Shreeyaj005/Darkviz/README.md

# Darkviz 

**Autonomous Omni-Directional Robotic System for Dark-Store Inventory Handling and Order Fulfillment**

---

## Team Details

| Sr. No. | Name of Student | Roll No. | Branch | Email ID |
|---|---|---|---|---|
| 1 | Shreeeya Jadhav | 45  | Automation and Robotics | 2023.shreeya.jadhav@ves.ac.in |
| 2 | Ayush Likhar | 11 | Automation and Robotics | 2023.ayush.likhar@ves.ac.in |
| 3 | Yash Gupta | 44 | Automation and Robotics | 2023.yash.gupta@ves.ac.in |
| 4 | Vedant Chavan | 40 | Automation and Robotics | 2023.vedant.chavan@ves.ac.in |

---
## Proposal 
https://youtu.be/7PNNnmAVzm0?si=SbWJWXD1Y0URtpTx

## Guide Details

**Project Guide: Amudha Senthilkumar**  
**Department:** Automation and Robotics  
**Institute:** VESIT, Mumbai  

---

## Problem Statement

> The aim of this project is to develop an autonomous robotic solution for inventory retrieval in quick-commerce dark stores by integrating omni-directional mobility, SLAM based navigation, and a tray based product retrieval mechanism to reduce human intervention, minimize picking errors, and improve the speed and consistency of order preparation.

---

## Abstract

### Abstract

Quick-commerce dark stores depend on rapid and accurate inventory retrieval to fulfill customer orders within short delivery times. Manual product picking can lead to delays, human errors, and increased operational effort. **DarkViz** is proposed as an autonomous robot to automate inventory retrieval and improve order preparation in dark stores.

The robot uses an **omni-directional drive system** and **SLAM (Simultaneous Localization and Mapping)** for indoor mapping, localization, and autonomous navigation. It is equipped with a **tray-based retrieval mechanism** to collect products from designated storage locations and transport them to the order-fulfillment area. Product locations can be assigned through an existing inventory management system.

The expected outcome is a functional prototype capable of accurately navigating the dark-store environment and retrieving products with minimal human intervention. The system can serve as a foundation for future **fully automated dark-store operations**, with applications in quick-commerce, warehouse automation, inventory management, and logistics.

---

## Objectives

1. To study existing inventory retrieval and automation challenges in quick-commerce dark stores and analyze available robotic solutions.
2. To design an omni-directional mobile robot with a suitable hardware, software, navigation, and tray-based product retrieval architecture.
3. To implement SLAM-based mapping and autonomous navigation along with the tray mechanism for automated product retrieval.
4. To test and validate the robot’s navigation, localization, product retrieval, and overall system performance in a simulated and physical dark-store     environment.
5. To document and present the design, implementation, results, and future scope of the DarkViz robotic system.

---

## Scope of the Project

* Development of the omni-directional robot prototype with tray based retrieval mechanism.
* Simulation of the robot and dark-store environment.
* Implementation of SLAM for mapping and localization.
* Development of autonomous navigation and robot control.
* Hardware-software integration and real-world testing.
* Performance testing of navigation and product retrieval.
* Foundation for a fully automated dark-store system.

---

## Existing System

Quick-commerce dark stores currently use inventory management software combined with manual human picking. While software manages inventory, order allocation, and picking routes, workers physically locate, retrieve, and transport products.

Limitations
- High dependence on manual labor.
- Increased risk of picking and fulfillment errors.
- Longer processing time during peak demand.
- Limited automation of inventory retrieval.
- Higher operational and labor costs.
- Poor scalability with increasing order volumes.
- Inconsistent performance due to human fatigue and errors.

---

## Proposed System

**DarkViz** is an autonomous omni-directional mobile robot designed to automate product retrieval in quick-commerce dark stores.

### How It Works

The robot uses **LiDAR-based SLAM** to map the dark store and determine its position. Once a product location is assigned by the inventory system, the robot autonomously navigates to the required shelf using **path planning and omni-directional motion**. A **motorized tray mechanism** then extends to retrieve the product and carries it to the designated order-fulfillment area.

### Major Components

* Omni-directional drive system
* LiDAR and SLAM
* ROS 2-based navigation and control
* Motor drivers and DC motors
* Automated tray retrieval mechanism
* Onboard processing unit
* Dark-store simulation environment

### Expected Benefits

* Reduced manual intervention
* Faster and more accurate product retrieval
* Reduced picking errors
* Consistent operation
* Foundation for a fully automated dark-store system

---

## System Architecture

The DarkViz architecture comprises the physical
robot hardware and two simulation environments.
Gazebo is used for LiDAR-based SLAM and navigation,
while MuJoCo is used to visualise the retractable
tray mechanism.

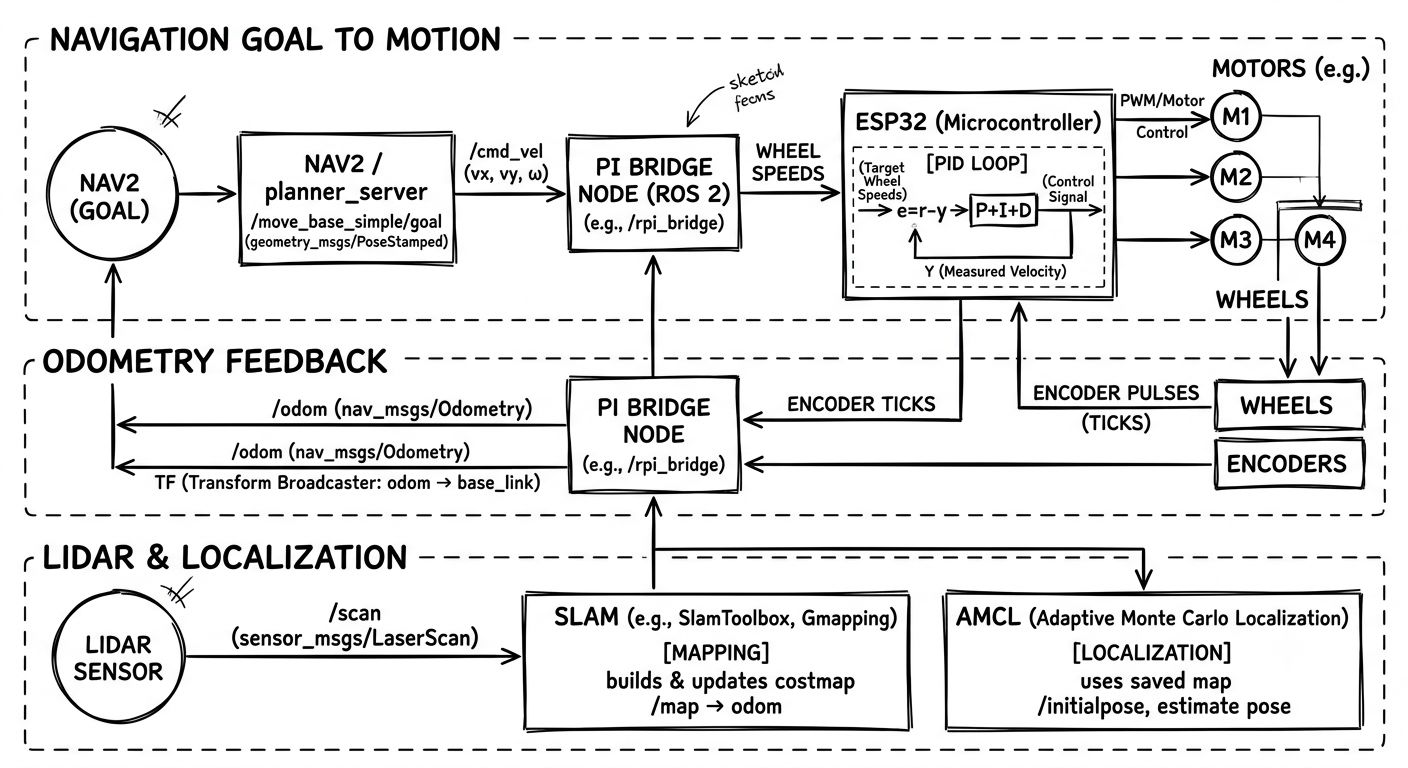
[picture p1: images/darkviz_system_architecture.png]
DarkViz System Architecture


---

## Hardware Requirements

| Sr. No. | Component | Specification | Quantity | Purpose |
| --- | --- | --- | --- | --- |
| 1 | TB6612FNG motor driver module | maximum voltage of 15VDC 1.2A per channel (or up to 3.2A for a short, single pulse) | 2 | To control the speed and direction of the robot’s DC motors by receiving control signals from the microcontroller and supplying the required current to each motor. |
| 2 | Pro-range Johnson motor | High Torque DC Motor 12V 600RPM encoder compatible | 3 | To provide the required torque and rotational motion for the robot’s omni-directional wheels, enabling controlled movement in different directions. |
| 3 | Omni Wheels | Body material: Aluminium Diameter: 60 mm.  Load capacity: 3 kg Number of rollers: 10 Roller material: Rubber  Number of plates: 6 | 3 | To provide omni-directional movement, allowing the robot to move forward, backward, sideways, and rotate in place for precise navigation within the dark store. |
| 4 | ESP WROOM 32 MCU Module Version: 1.1 microcontroller | generic WiFi-BT-BLE MCU module | 1 | To serve as the robot’s main microcontroller, processing control commands and managing motor drivers, sensors, and communication for autonomous robot operation. |
| 5 | raspi 4 model B | Broadcom BCM2711 Quad-core 64-bit Cortex-A72 @ 1.8 GHz, 4 GB LPDDR4 RAM, Wi-Fi, Bluetooth 5.0, Gigabit Ethernet, 40-pin GPIO | 1 | Main onboard computer for running ROS 2, SLAM, navigation algorithms, sensor processing, and high-level robot control |
| 6 | Battery | 8000mah | 1 | To provide the primary power supply for the robot’s motors, microcontrollers, sensors, and other electronic components. |
---

## Software Requirements

| Sr. No. | Software / Tool | Version | Purpose |
| --- | --- | --- | --- |
| 1 | Gazebo/Ignition | Gazebo Fortress | Simulation of the robot, sensors, environment, and navigation |
| 2 | RViz2 | ROS 2 Humble | Visualization of SLAM maps, robot pose, LiDAR data, TF, and navigation |
| 3 | Ubuntu | 22.04 LTS | Operating system for running ROS 2, Gazebo, RViz2, and robot software |

---

## Technologies Used

- ROS 2 Humble – Robot software framework
- Python / C++ – Algorithm development and robot control
- SLAM – Indoor mapping and localization
- Nav2 – Autonomous navigation and path planning
- Gazebo – Robot and environment simulation
- RViz2 – Visualization and monitoring
- Raspberry Pi 4B – Main processing unit
- ESP32 – Motor and hardware control
- LiDAR – Environment sensing and mapping
- Autodesk Fusion – 3D CAD design of the robot and tray mechanism
- Embedded Systems – Motor drivers, motors, sensors, and actuator integration

---

## Methodology

Explain the step-by-step approach.

1. Literature survey
2. Problem identification
3. Requirement analysis
4. System design
5. Hardware/software development
6. Integration
7. Testing and validation
8. Documentation and publication

---

## Project Timeline

| Week / Month | Task Planned | Status |
| --- | --- | --- |
| Week 1 | Problem finalization  | Completed |
| Week 2 | Literature survey | Completed |
| Week 3 | Requirement analysis  | Completed |
| Week 4 | System design | In Progress |
| Week 5 | Prototype development | In Progress |
| Week 6 | Testing | Pending |
| Week 7 | Documentation | In Progress |
| Week 8 | Paper writing | In Progress |

---

## Weekly Progress Updates

| Week | Date | Work Completed | Work Planned for Next Week | Issues / Challenges | GitHub Commit Link |
|---|---|---|---|---|---|
| Week 1 | 11-13 Aug 2026 | Set up the Gazebo warehouse environment and integrated the omni-wheel robot. Added initial CAD files and project documentation. | Implement SLAM and autonomous navigation. | - **Gazebo Simulation:** Encountered server-side issues while launching Gazebo, requiring troubleshooting of the simulation environment.- **ROS 2 Integration:** Learning the ROS 2 filesystem structure and package organization to configure and launch the robot simulation.- **Omni-Wheel Kinematics:** Working on simulating the robot using ROS 2 control interfaces, with motion control based on kiwi-drive kinematics. | [Commits](https://github.com/Shreeyaj005/Darkviz/commits/main/?since=2026-08-11&until=2026-08-13) |
| Week 2 | 14-22 Aug 2026 | Integrated SLAM, omni-drive control and autonomous navigation. Added coordinate-based navigation and waypoint selection. | Improve navigation and robot control. | **Map Generation and Optimization**: Studying the effects of LiDAR data, sensor noise, map resolution, and SLAM parameters on map quality.-**Map Acquisition**: Exploring how to generate, save, and reload maps for autonomous navigation.-**Robot–Map Coordination**: Understanding coordinate frames, TF transformations, localization, and odometry to align the robot's pose with the map.  | [Commits](https://github.com/Shreeyaj005/Darkviz/commits/main/?since=2026-08-14&until=2026-08-22) |
| Week 3 | 31 Aug-5 Sep 2026 | Added simulation documentation and migrated the ROS 2 setup to Humble. Updated project setup instructions. | Refine ROS 2 integration and robot control. | ROS 2 package and dependency compatibility. | [Commits](https://github.com/Shreeyaj005/Darkviz/commits/main/?since=2026-08-31&until=2026-09-05) |
| Week 4 | 22-23 Sep 2026 | started with the hardware design, tested motors with driver individually | Refine robot control and document hardware connections. | Odometry accuracy and motion control debugging. | [Commits](https://github.com/Shreeyaj005/Darkviz/commits/main/?since=2026-09-22&until=2026-09-23) |
| Week 5 | Hardware Design & Testing | designed the robot hardware, 3D-printed structural components and omni-wheel couplers, and individually tested the motors with their motor drivers. | Refine the mechanical design, verify motor-driver functionality, and prepare for hardware integration. | - **Motor Power Testing:** Observed voltage drops while operating the motors at a 6 V supply, despite their 12 V maximum rated voltage, highlighting the need to investigate power supply limitations and current demand under load.<br>- **Mechanical Design Optimization:** Explored a sleek, warehouse-oriented robot design focused on compactness and efficient movement in constrained spaces.<br>- **Load-Bearing Mobility:** Evaluated design considerations for moving loads smoothly using omni-wheels while maintaining stability and maneuverability.<br>- **Design Simplification:** Reassessed the initial mechanical design to reduce complexity and make fabrication, assembly, and integration easier. <br> Resolve electrical faults, establish reliable power distribution, and ensure consistent PWM-based motor control through the ESP32. - **Perfboard Assembly:** Implemented the motor control circuit on a perfboard and tested individual motor operation.<br>- **Power Distribution:** Investigated power delivery issues affecting motor and controller operation.<br>- **Short-Circuit Detection:** Identified and troubleshot short circuits and wiring faults in the assembled connections.<br>- **PWM Signal Debugging:** Investigated issues with PWM signal transmission from the ESP32 to the motor drivers.<br>- **ESP32 Integration:** Troubleshot controller power and connection issues to improve reliable communication with the motor drivers. | [Commits](https://github.com/Shreeyaj005/Darkviz/commits/main/?since=2026-10-08&until=2026-10-23) |
| Week 6 | 24-28 Oct 2026 | Drafted the Kiwi-drive PCB and circuit schematic, documented motor and encoder connections, and updated the simulation model to match the physical robot. | Optimize PCB size, improve connection accessibility, and develop a reliable layout for hardware integration. | - **PCB Miniaturization:** Working on reducing PCB dimensions while maintaining sufficient spacing and practical component placement.<br>- **Connection Accessibility:** Organizing connectors and pin assignments to simplify wiring, assembly, and debugging.- **PCB Design Tools:** Learning KiCad for schematic design, footprint assignment, component placement, and PCB routing.<br>- **Hardware Integration:** Addressing component compatibility, pin mapping, power distribution, and grounding requirements for reliable operation. | [Commits](https://github.com/Shreeyaj005/Darkviz/commits/main/?since=2026-10-24&until=2026-10-28) |
| Week 7 | 29 Oct-4 Nov 2026 | Consolidated project documentation, reviewed the simulation and hardware implementation, and prepared review materials. | Present project progress and incorporate review feedback. | Final documentation and integration checks. | [Repository](https://github.com/Shreeyaj005/Darkviz) |
| Week 8 | 5 Nov 2026 | Presenting the project implementation, hardware progress and simulation results during the scheduled review. | Incorporate feedback and plan the next development phase. | Pending review feedback. | [Repository](https://github.com/Shreeyaj005/Darkviz) |

Upcoming Milestone: Project Progress Review – 5 November 2026.

---

## Design Files

Upload and link all design files here.

| File Type | File Name / Link | Description |
| --- | --- | --- |
| CAD Model | Darkviz/hardware | Folder contains .step and .stl files for model  |
| Circuit Diagram | | |
| PCB Design | | |
| Flowchart | | |
| Simulation File |simulation/kiwi_robot/scripts/autonomous_controller.py  | Autonomous controller script for the robot to explore environment. Run slam.launch.py before running the script|

---

## Circuit Diagram

Add circuit diagram image here.

```markdown
![Circuit Diagram](images/circuit_diagram.png)
```

---

## Flowchart / Algorithm
SLAM

### Algorithm

1. **Initialize System** : Start ROS 2 nodes, robot model, sensors, and simulation environment.
2. **Map Environment** : Use LiDAR and odometry with SLAM Toolbox to generate a 2D map of the dark-store.
3. **Localize Robot**: Estimate the robot's position within the generated map.
4. **Set Target** : Receive the target shelf or order-fulfillment location.
5. **Plan Path** : Use Nav2 to generate a collision-free path to the target.
6. **Navigate** : Generate velocity commands and move the omni-directional robot toward the target.
7. **Avoid Obstacles** : Continuously process LiDAR data and update navigation commands when obstacles are detected.
8. **Complete Task** : Stop at the target location or proceed to the next assigned target.
9. **Repeat** : Continue the process until all assigned tasks are completed.

---

## Implementation Details

DarkViz is implemented as a ROS 2 Humble-based autonomous omni-directional robotic system designed for inventory handling and order fulfillment in a dark-store environment. The system combines robot modelling, LiDAR-based perception, odometry, 2D SLAM, autonomous navigation, and motion control within a Gazebo simulation.

### Hardware Implementation

Write details about connections, components, power supply, sensors, actuators, PCB, enclosure, etc.

### Software Implementation

DarkViz is implemented using **ROS 2 Humble** with Gazebo for simulation and RViz2 for visualization. The robot is modelled using **URDF/Xacro**, while Python and C++ ROS 2 nodes handle control, odometry, sensor processing, and navigation.

* **SLAM Toolbox**: 2D mapping and localization using LiDAR and odometry
* **Nav2**: autonomous path planning and obstacle avoidance
* **ROS 2 Topics & TF**: communication and coordinate-frame management
* **Gazebo**: dark-store environment and robot simulation
* **RViz2**: visualization of maps, LiDAR, TF, and navigation
* **Python/C++**: robot control and processing nodes

The overall pipeline is:

**LiDAR + Odometry → SLAM/Localization → Navigation → `/cmd_vel` → Omni-directional Robot Motion**

---

## Code Structure

```text
Darkviz/
│
├── docs/
│   └── literarture_survey.md
│
├── hardware/
│   ├── darkviz_base.f3d
│   ├── darkviz_base.stl
│   ├── final design.step
│   └── hardware.md
│
├── images/
│   ├── 3d_printed_prototype_assembled.jpg
│   ├── 3d_printed_prototype_top_view.jpg
│   ├── Ideation.jpeg
│   ├── images.md
│   └── Linear Guide Rail.png
│
├── simulation/
│   ├── kiwi_robot/
│   │   ├── CMakeLists.txt
│   │   ├── package.xml
│   │   ├── config/
│   │   ├── launch/
│   │   ├── scripts/
│   │   ├── urdf/
│   │   └── worlds/
│   │
│   └── README.md
│
├── software/
│   ├── kiwi_drive_control.ino
│   └── software.md
│
├── reference/
│   └── paper.md
│
└── README.md```

---

## How to Run the Project

### Step 1: Clone the Repository

```bash
git clone https://github.com/Shreeyaj005/Darkviz.git
cd Darkviz/software/simulation
```

### Step 2: Install Dependencies

```bash
source /opt/ros/humble/setup.bash
colcon build
source install/setup.bash
```

### Step 3: Launch Simulation

```bash
ros2 launch kiwi_robot gazebo.launch.py
```
This launches the DarkViz robot and the simulated dark-store environment in Gazebo.

### Step 4: Run SLAM
In a new terminal:
```bash
cd ~/Darkviz/software/simulation
source /opt/ros/humble/setup.bash
source install/setup.bash
ros2 launch kiwi_robot slam.launch.py
```
RViz2 can be used to visualize the LiDAR data, TF frames, and generated 2D map.

### Step 5: Control and Navigate the Robot
The robot can be controlled using the available ROS 2 control/navigation nodes. Navigation commands are published through /cmd_vel, while LiDAR and odometry provide feedback for localization and obstacle avoidance.

### Expected Output
The Gazebo simulation should start with the DarkViz omni-directional robot inside the simulated dark-store. The robot's LiDAR and odometry data should be available through ROS 2 topics, and SLAM should progressively generate a 2D map of the environment.

---

## Testing and Results

| Test No. | Test Description | Expected Result | Actual Result | Status |
| --- | --- | --- | --- | --- |
| 1 | | | | Pass / Fail |
| 2 | | | | Pass / Fail |
| 3 | | | | Pass / Fail |

---

## Result Images / Videos

WhatsApp Image 2026-09-22 at 9 46 26 PM

Video Link:
https://youtu.be/ZUh2bRQQ1O0
---

## Applications

1. Dark-Store Order Fulfillment: Autonomous movement between storage shelves and order collection areas.
2. Inventory Management: Automated navigation for inventory inspection, stock monitoring, and shelf-level data collection.
3. Warehouse Automation: Autonomous transportation of goods between storage and packing areas.

---

## Advantages

1. Omni-Directional Mobility: Enables lateral movement and precise positioning in narrow aisles.
2. Autonomous Navigation: Uses SLAM and Nav2 for mapping, localization, path planning, and obstacle avoidance.
3. Modular ROS 2 Architecture: Individual perception, control, and navigation components can be developed and modified independently.
4. Simulation-Based Development: Gazebo enables testing and validation of the robotic system before deployment on physical hardware.
---

## Limitations
1. Simulation Environment: Current implementation is primarily validated in simulation and may require further testing on physical hardware.
2. 2D Perception: The current LiDAR-based system provides primarily 2D environmental information.
3. Simplified Inventory Handling: Physical picking, gripping, and placement mechanisms are not yet fully integrated.
4. Environmental Dependence: Navigation performance can be affected by dynamic obstacles, sensor noise, and changes in the store layout.

---

## Future Scope
1. Automated Picking: Add robotic manipulation for shelf-level item detection, picking, and placement.
2. Computer Vision Integration: Use cameras and vision models for product recognition, shelf monitoring, and inventory tracking.
3. Multi-Robot Coordination: Extend the system to coordinate multiple robots for parallel order fulfillment and inventory operations.

---

## Research Paper / Publication

| Item | Details |
| --- | --- |
| Paper Title | DarkViz: Design and Performance Evaluation of a Three-Wheeled Omni-Directional Mobile Robot for Autonomous Navigation in Space-Constrained Darkstores |
| Conference / Journal Name | |
| Paper Status |  Drafting |
| Submission Date | |
| Paper Link | |

---

## References
```text
[1] L. Tagliavini, G. Colucci, A. Botta, P. Cavallone, L. Baglieri, and G. Quaglia, "Wheeled Mobile Robots: State of the Art Overview and Kinematic Comparison Among Three Omnidirectional Locomotion Strategies," Journal of Intelligent & Robotic Systems, vol. 106, Art. no. 57, 2022, doi: 10.1007/s10846-022-01745-7.

[2] D. Martínez, E. Rubies, R. Bitriá, and J. Palacín, "Evaluation and Correction of Systematic Motion Errors in a Compact Three-Wheeled Omnidirectional Platform Based on Servomotors," Applied Sciences, vol. 15, no. 19, Art. no. 10700, 2025, doi: 10.3390/app151910700.

[3] J. Moreno, E. Clotet, R. Lupiañez, M. Tresanchez, D. Martínez, T. Pallejà, J. Casanovas, and J. Palacín, "Design, Implementation and Validation of the Three-Wheel Holonomic Motion System of the Assistant Personal Robot (APR)," Sensors, vol. 16, no. 10, Art. no. 1658, 2016, doi: 10.3390/s16101658.

[4] L. Li, L. Schulze, and K. Kalavadia, "Promising SLAM Methods for Automated Guided Vehicles and Autonomous Mobile Robots," Procedia Computer Science, vol. 232, pp. 2867–2874, 2024, doi: 10.1016/j.procs.2024.02.103.

[5] R. Keith and H. M. La, "Review of Autonomous Mobile Robots for the Warehouse Environment," arXiv preprint arXiv:2406.08333, 2024. [Online]. Available: https://arxiv.org/abs/2406.08333.

[6] G. Fragapane, R. de Koster, F. Sgarbossa, and J. O. Strandhagen, "Planning and Control of Autonomous Mobile Robots for Intralogistics: Literature Review and Research Agenda," European Journal of Operational Research, vol. 294, no. 2, pp. 405–426, 2021, doi: 10.1016/j.ejor.2021.01.019.

[7] K. Azadeh, R. de Koster, and D. Roy, "Robotized and Automated Warehouse Systems: Review and Recent Developments," Transportation Science, vol. 53, no. 4, pp. 917–945, 2019, doi: 10.1287/trsc.2018.0873.

[8] Í. R. da Costa Barros and T. P. Nascimento, "Robotic Mobile Fulfillment Systems: A Survey on Recent Developments and Research Opportunities," Robotics and Autonomous Systems, vol. 137, Art. no. 103729, 2021, doi: 10.1016/j.robot.2021.103729.

[9] H. Taheri, B. Qiao, and N. Nurre, "Kinematic Model of a Three-Wheeled Omnidirectional Mobile Robot," The International Journal of Advanced Manufacturing Technology, vol. 78, pp. 1563–1571, 2015, doi: 10.1007/s00170-014-6761-3.

[10] R. Rojas, "Kinematics of Omnidirectional Robots," Freie Universität Berlin, Technical Report, 2005.

[11] R. Siegwart, I. R. Nourbakhsh, and D. Scaramuzza, Introduction to Autonomous Mobile Robots, 2nd ed. Cambridge, MA, USA: MIT Press, 2011.
```

---

## Repository Update Guidelines

Each student team must update the GitHub repository regularly.

Minimum expected updates:

* Update README every week.
* Push code changes regularly.
* Upload circuit diagrams, CAD files, PCB files, reports and presentations.
* Add weekly progress in the progress table.
* Maintain proper folder structure.
* Do not upload unnecessary temporary files.
* Each major update should have a meaningful commit message.

Example commit messages:

```text
Added problem statement and objectives
Updated system architecture diagram
Added sensor interfacing code
Updated weekly progress for Week 3
Added testing results and prototype images
```

---

## Declaration

We declare that this project work is carried out by our team as part of the BE Capstone Project. The work will be regularly updated on GitHub and all references used will be properly cited.

---

## License

This project is for academic use only.

Optional:

```text
MIT License / Creative Commons / Institute Use Only
```

```
```
