Shreeyaj005/Darkviz/images/Ideation.jpeg

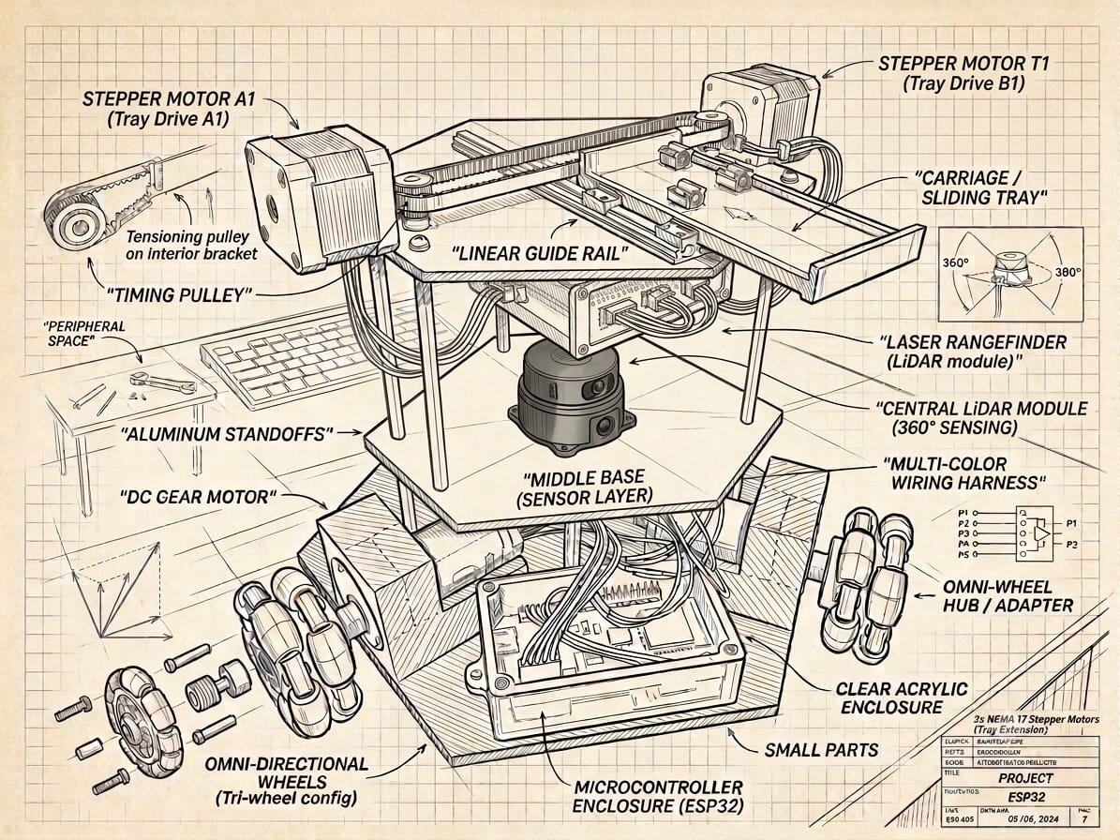
images/Ideation.jpeg
