Shreeyaj005/Darkviz/hardware/CAD/darkviz_base.3mf

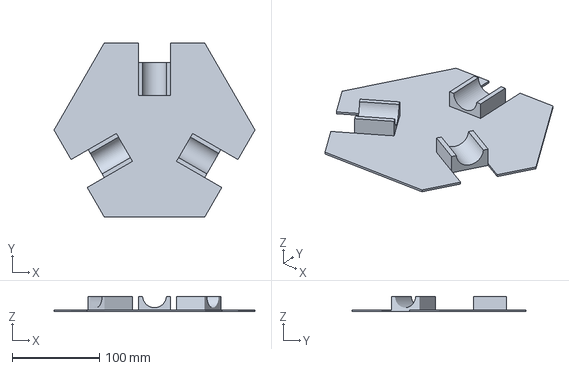
[picture p3: CAD file, 2026-10-24]
hardware/CAD/darkviz_base.3mf
230.7 x 199.9 x 17.6 mm
