Shreeyaj005/Darkviz/hardware/final design.step

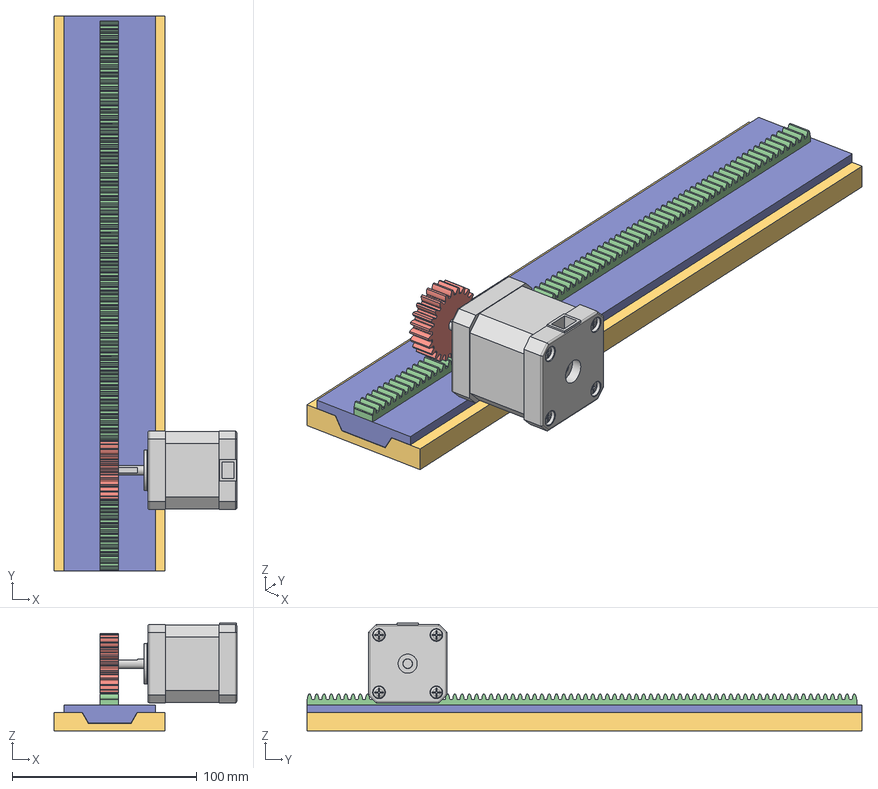
[picture p4: CAD file, 2026-09-22]
hardware/final design.step
98.7 x 300.0 x 58.3 mm
6627T91_Stepper Motor
