Shreeyaj005/Darkviz/(list of files, cad)

Other CAD files:
hardware/darkviz_base.f3d
hardware/darkviz_base.stl
