Shreeyaj005/Darkviz/simulation/kiwi_robot/urdf/kiwi_updated_robot.mjcf.xml

<mujoco model="kiwi_robot">
  <compiler angle="radian"/>

  <worldbody>
    <body name="base_footprint">
      <freejoint name="base_joint"/>
      <body name="base_link" pos="0 0 0.096">
        <inertial pos="0 0 0" quat="0.5 0.5 -0.5 0.5" mass="5" diaginertia="0.121 0.06056 0.06056"/>
        <geom size="0.11 0.190526 0.006" quat="0.965926 0 0 0.258819" type="box" contype="0" conaffinity="0" group="1" density="0" rgba="0.88 0.88 0.85 1"/>
        <geom size="0.11 0.190526 0.006" quat="0.965926 0 0 0.258819" type="box" rgba="0.88 0.88 0.85 1"/>
        <geom size="0.11 0.190526 0.006" quat="0.707107 0 0 0.707107" type="box" contype="0" conaffinity="0" group="1" density="0" rgba="0.88 0.88 0.85 1"/>
        <geom size="0.11 0.190526 0.006" quat="0.707107 0 0 0.707107" type="box" rgba="0.88 0.88 0.85 1"/>
        <geom size="0.11 0.190526 0.006" quat="0.258819 0 0 0.965926" type="box" contype="0" conaffinity="0" group="1" density="0" rgba="0.88 0.88 0.85 1"/>
        <geom size="0.11 0.190526 0.006" quat="0.258819 0 0 0.965926" type="box" rgba="0.88 0.88 0.85 1"/>
        <body name="mid_plate" pos="0 0 0.101">
          <inertial pos="0 0 0" quat="0.5 0.5 -0.5 0.5" mass="0.5" diaginertia="0.0121 0.00605417 0.00605417"/>
          <geom size="0.11 0.190526 0.005" quat="0.965926 0 0 0.258819" type="box" contype="0" conaffinity="0" group="1" density="0" rgba="0.88 0.88 0.85 1"/>
          <geom size="0.11 0.190526 0.005" quat="0.707107 0 0 0.707107" type="box" contype="0" conaffinity="0" group="1" density="0" rgba="0.88 0.88 0.85 1"/>
          <geom size="0.11 0.190526 0.005" quat="0.258819 0 0 0.965926" type="box" contype="0" conaffinity="0" group="1" density="0" rgba="0.88 0.88 0.85 1"/>
        </body>
        <body name="top_plate" pos="0 0 0.231">
          <inertial pos="0 0 0" quat="0.5 0.5 -0.5 0.5" mass="0.5" diaginertia="0.0121 0.00605417 0.00605417"/>
          <geom size="0.11 0.190526 0.005" quat="0.965926 0 0 0.258819" type="box" contype="0" conaffinity="0" group="1" density="0" rgba="0.88 0.88 0.85 1"/>
          <geom size="0.11 0.190526 0.005" quat="0.965926 0 0 0.258819" type="box" rgba="0.88 0.88 0.85 1"/>
          <geom size="0.11 0.190526 0.005" quat="0.707107 0 0 0.707107" type="box" contype="0" conaffinity="0" group="1" density="0" rgba="0.88 0.88 0.85 1"/>
          <geom size="0.11 0.190526 0.005" quat="0.707107 0 0 0.707107" type="box" rgba="0.88 0.88 0.85 1"/>
          <geom size="0.11 0.190526 0.005" quat="0.258819 0 0 0.965926" type="box" contype="0" conaffinity="0" group="1" density="0" rgba="0.88 0.88 0.85 1"/>
          <geom size="0.11 0.190526 0.005" quat="0.258819 0 0 0.965926" type="box" rgba="0.88 0.88 0.85 1"/>
        </body>
        <body name="standoff_1" pos="0.129904 0.075 0.116">
          <inertial pos="0 0 0" mass="0.06" diaginertia="0.00024254 0.00024254 1.08e-06"/>
          <geom size="0.006 0.11" type="cylinder" contype="0" conaffinity="0" group="1" density="0" rgba="0.7 0.7 0.75 1"/>
        </body>
        <body name="standoff_2" pos="-0.129904 0.075 0.116">
          <inertial pos="0 0 0" mass="0.06" diaginertia="0.00024254 0.00024254 1.08e-06"/>
          <geom size="0.006 0.11" type="cylinder" contype="0" conaffinity="0" group="1" density="0" rgba="0.7 0.7 0.75 1"/>
        </body>
        <body name="standoff_3" pos="0 -0.15 0.116">
          <inertial pos="0 0 0" mass="0.06" diaginertia="0.00024254 0.00024254 1.08e-06"/>
          <geom size="0.006 0.11" type="cylinder" contype="0" conaffinity="0" group="1" density="0" rgba="0.7 0.7 0.75 1"/>
        </body>
        <body name="enclosure" pos="0 0 0.031">
          <inertial pos="0 0 0" quat="0 0.707107 0 0.707107" mass="0.3" diaginertia="0.0009425 0.0007025 0.000365"/>
          <geom size="0.08 0.055 0.025" type="box" contype="0" conaffinity="0" group="1" density="0" rgba="0.75 0.88 1 0.35"/>
        </body>
        <body name="esp32_carrier" pos="0 0 0.012">
          <inertial pos="0 0 0" quat="0 0.707107 0 0.707107" mass="0.03" diaginertia="4.825e-05 3.604e-05 1.229e-05"/>
          <geom size="0.06 0.035 0.002" type="box" contype="0" conaffinity="0" group="1" density="0" rgba="0.1 0.45 0.2 1"/>
        </body>
        <body name="esp32_module" pos="0 0 0.017">
          <inertial pos="0 0 0" quat="0 0.707107 0 0.707107" mass="0.01" diaginertia="2.90667e-06 2.28333e-06 6.83333e-07"/>
          <geom size="0.026 0.014 0.003" type="box" contype="0" conaffinity="0" group="1" density="0" rgba="0.1 0.1 0.12 1"/>
        </body>
        <body name="front_hub" pos="0 0.1475 -0.036" quat="0 0 0.707107 0.707107">
          <inertial pos="0 0 0" mass="0.25" diaginertia="0.000281771 0.000281771 0.000104167"/>
          <geom size="0.025 0.0375" type="cylinder" contype="0" conaffinity="0" group="1" density="0" rgba="0.35 0.37 0.42 1"/>
          <geom size="0.025 0.025 0.015" pos="0 0 0.0525" type="box" contype="0" conaffinity="0" group="1" density="0" rgba="0.7 0.7 0.75 1"/>
          <geom size="0.02 0.01" pos="0 0 -0.0475" type="cylinder" contype="0" conaffinity="0" group="1" density="0" rgba="0.1 0.1 0.12 1"/>
        </body>
        <body name="front_wheel" pos="0 0.24 -0.036" quat="0 0 0.707107 0.707107">
          <inertial pos="0 0 0" quat="0.5 0.5 -0.5 0.5" mass="0.9" diaginertia="0.00162 0.0009975 0.0009975"/>
          <joint name="front_wheel_joint" pos="0 0 0" axis="0 0 1" damping="0.01" frictionloss="0.005"/>
          <geom size="0.05 0.022" type="cylinder" contype="0" conaffinity="0" group="1" density="0" rgba="0.7 0.7 0.75 1"/>
          <geom size="0.016 0.012" pos="0.044 0 0.013" quat="0.707107 0.707107 0 0" type="cylinder" contype="0" conaffinity="0" group="1" density="0" rgba="0.12 0.12 0.13 1"/>
          <geom size="0.016 0.012" pos="0.0311127 0.0311127 0.013" quat="0.653281 0.653281 0.270598 0.270598" type="cylinder" contype="0" conaffinity="0" group="1" density="0" rgba="0.12 0.12 0.13 1"/>
          <geom size="0.016 0.012" pos="0 0.064 0.013" quat="0.5 0.5 0.5 0.5" type="cylinder" contype="0" conaffinity="0" group="1" density="0" rgba="0.12 0.12 0.13 1"/>
          <geom size="0.016 0.012" pos="-0.0311127 0.0311127 0.013" quat="0.270598 0.270598 0.653281 0.653281" type="cylinder" contype="0" conaffinity="0" group="1" density="0" rgba="0.12 0.12 0.13 1"/>
          <geom size="0.016 0.012" pos="-0.044 0 0.013" quat="0 0 0.707107 0.707107" type="cylinder" contype="0" conaffinity="0" group="1" density="0" rgba="0.12 0.12 0.13 1"/>
          <geom size="0.016 0.012" pos="-0.0311127 -0.0311127 0.013" quat="-0.270598 -0.270598 0.653281 0.653281" type="cylinder" contype="0" conaffinity="0" group="1" density="0" rgba="0.12 0.12 0.13 1"/>
          <geom size="0.016 0.012" pos="0 -0.064 0.013" quat="-0.5 -0.5 0.5 0.5" type="cylinder" contype="0" conaffinity="0" group="1" density="0" rgba="0.12 0.12 0.13 1"/>
          <geom size="0.016 0.012" pos="0.0311127 -0.0311127 0.013" quat="-0.653281 -0.653281 0.270598 0.270598" type="cylinder" contype="0" conaffinity="0" group="1" density="0" rgba="0.12 0.12 0.13 1"/>
          <geom size="0.016 0.012" pos="0.0406514 0.0168381 -0.013" quat="0.69352 0.69352 0.13795 0.13795" type="cylinder" contype="0" conaffinity="0" group="1" density="0" rgba="0.12 0.12 0.13 1"/>
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
        </body>
        <body name="lidar_link" pos="0 0 0.146">
          <inertial pos="0 0 0" quat="0.5 0.5 -0.5 0.5" mass="0.6" diaginertia="0.00147 0.001055 0.001055"/>
          <geom size="0.07 0.04" type="cylinder" contype="0" conaffinity="0" group="1" density="0" rgba="0.08 0.08 0.1 1"/>
          <geom size="0.07 0.04" type="cylinder" rgba="0.08 0.08 0.1 1"/>
        </body>
        <body name="rangefinder_module" pos="0 0 0.206">
          <inertial pos="0 0 0" quat="0 0.707107 0 0.707107" mass="0.1" diaginertia="0.000160833 0.000133333 5.41667e-05"/>
          <geom size="0.06 0.035 0.02" type="box" contype="0" conaffinity="0" group="1" density="0" rgba="0.2 0.2 0.2 1"/>
        </body>
        <body name="stepper_a1" pos="-0.12 0.1 0.2585">
          <inertial pos="0 0 0" quat="0.5 0.5 -0.5 0.5" mass="0.3" diaginertia="0.000125 0.000113125 0.000113125"/>
          <geom size="0.025 0.025 0.0225" type="box" contype="0" conaffinity="0" group="1" density="0" rgba="0.1 0.1 0.12 1"/>
        </body>
        <body name="stepper_t1" pos="-0.12 -0.1 0.2585">
          <inertial pos="0 0 0" quat="0.5 0.5 -0.5 0.5" mass="0.3" diaginertia="0.000125 0.000113125 0.000113125"/>
          <geom size="0.025 0.025 0.0225" type="box" contype="0" conaffinity="0" group="1" density="0" rgba="0.1 0.1 0.12 1"/>
        </body>
        <body name="timing_pulley_a1" pos="-0.12 0.1 0.288">
          <inertial pos="0 0 0" quat="0.5 0.5 -0.5 0.5" mass="0.02" diaginertia="1.44e-06 1.04667e-06 1.04667e-06"/>
          <geom size="0.012 0.007" type="cylinder" contype="0" conaffinity="0" group="1" density="0" rgba="0.7 0.7 0.75 1"/>
        </body>
        <body name="timing_pulley_t1" pos="-0.12 -0.1 0.288">
          <inertial pos="0 0 0" quat="0.5 0.5 -0.5 0.5" mass="0.02" diaginertia="1.44e-06 1.04667e-06 1.04667e-06"/>
          <geom size="0.012 0.007" type="cylinder" contype="0" conaffinity="0" group="1" density="0" rgba="0.7 0.7 0.75 1"/>
        </body>
        <body name="idler_post_a1" pos="0.15 0.1 0.262">
          <inertial pos="0 0 0" mass="0.02" diaginertia="4.58667e-06 4.58667e-06 1.6e-07"/>
          <geom size="0.004 0.026" type="cylinder" contype="0" conaffinity="0" group="1" density="0" rgba="0.7 0.7 0.75 1"/>
        </body>
        <body name="idler_post_t1" pos="0.15 -0.1 0.262">
          <inertial pos="0 0 0" mass="0.02" diaginertia="4.58667e-06 4.58667e-06 1.6e-07"/>
          <geom size="0.004 0.026" type="cylinder" contype="0" conaffinity="0" group="1" density="0" rgba="0.7 0.7 0.75 1"/>
        </body>
        <body name="idler_pulley_a1" pos="0.15 0.1 0.295">
          <inertial pos="0 0 0" quat="0.5 0.5 -0.5 0.5" mass="0.02" diaginertia="1.44e-06 1.04667e-06 1.04667e-06"/>
          <geom size="0.012 0.007" type="cylinder" contype="0" conaffinity="0" group="1" density="0" rgba="0.7 0.7 0.75 1"/>
        </body>
        <body name="idler_pulley_t1" pos="0.15 -0.1 0.295">
          <inertial pos="0 0 0" quat="0.5 0.5 -0.5 0.5" mass="0.02" diaginertia="1.44e-06 1.04667e-06 1.04667e-06"/>
          <geom size="0.012 0.007" type="cylinder" contype="0" conaffinity="0" group="1" density="0" rgba="0.7 0.7 0.75 1"/>
        </body>
        <body name="belt_a1_outer" pos="0.015 0.112 0.295">
          <inertial pos="0 0 0" quat="0.5 0.5 0.5 0.5" mass="0.03" diaginertia="0.0001825 0.000182273 2.725e-07"/>
          <geom size="0.135 0.0015 0.005" type="box" contype="0" conaffinity="0" group="1" density="0" rgba="0.12 0.12 0.13 1"/>
        </body>
        <body name="belt_a1_inner" pos="0.015 0.088 0.295">
          <inertial pos="0 0 0" quat="0.5 0.5 0.5 0.5" mass="0.03" diaginertia="0.0001825 0.000182273 2.725e-07"/>
          <geom size="0.135 0.0015 0.005" type="box" contype="0" conaffinity="0" group="1" density="0" rgba="0.12 0.12 0.13 1"/>
        </body>
        <body name="belt_t1_outer" pos="0.015 -0.112 0.295">
          <inertial pos="0 0 0" quat="0.5 0.5 0.5 0.5" mass="0.03" diaginertia="0.0001825 0.000182273 2.725e-07"/>
          <geom size="0.135 0.0015 0.005" type="box" contype="0" conaffinity="0" group="1" density="0" rgba="0.12 0.12 0.13 1"/>
        </body>
        <body name="belt_t1_inner" pos="0.015 -0.088 0.295">
          <inertial pos="0 0 0" quat="0.5 0.5 0.5 0.5" mass="0.03" diaginertia="0.0001825 0.000182273 2.725e-07"/>
          <geom size="0.135 0.0015 0.005" type="box" contype="0" conaffinity="0" group="1" density="0" rgba="0.12 0.12 0.13 1"/>
        </body>
        <body name="linear_guide_rail" pos="0.02 0 0.242">
          <inertial pos="0 0 0" quat="0 0.707107 0 0.707107" mass="0.2" diaginertia="0.00193627 0.00192907 1.2e-05"/>
          <geom size="0.17 0.012 0.006" type="box" contype="0" conaffinity="0" group="1" density="0" rgba="0.7 0.7 0.75 1"/>
        </body>
        <body name="tray_link" pos="0 0 0.254">
          <inertial pos="0 0 0" quat="0 0.707107 0 0.707107" mass="0.5" diaginertia="0.00273333 0.00170417 0.00110417"/>
          <joint name="tray_joint" pos="0 0 0" axis="1 0 0" type="slide" range="0 0.15" actuatorfrcrange="-60 60" damping="5" frictionloss="1"/>
          <geom size="0.035 0.025 0.006" type="box" contype="0" conaffinity="0" group="1" density="0" rgba="0.2 0.2 0.2 1"/>
          <geom size="0.1 0.08 0.003" pos="0.02 0 0.009" type="box" contype="0" conaffinity="0" group="1" density="0" rgba="0.88 0.88 0.85 1"/>
          <geom size="0.1 0.08 0.003" pos="0.02 0 0.009" type="box" rgba="0.88 0.88 0.85 1"/>
          <geom size="0.003 0.08 0.015" pos="0.117 0 0.027" type="box" contype="0" conaffinity="0" group="1" density="0" rgba="0.88 0.88 0.85 1"/>
          <geom size="0.003 0.08 0.015" pos="0.117 0 0.027" type="box" rgba="0.88 0.88 0.85 1"/>
        </body>
      </body>
    </body>
  </worldbody>
</mujoco>
