Shreeyaj005/Darkviz/hardware/PCB/initial_pcb_draft.kicad_pcb

## KiCad design hardware/PCB/initial_pcb_draft.kicad_pcb (2026-10-24)

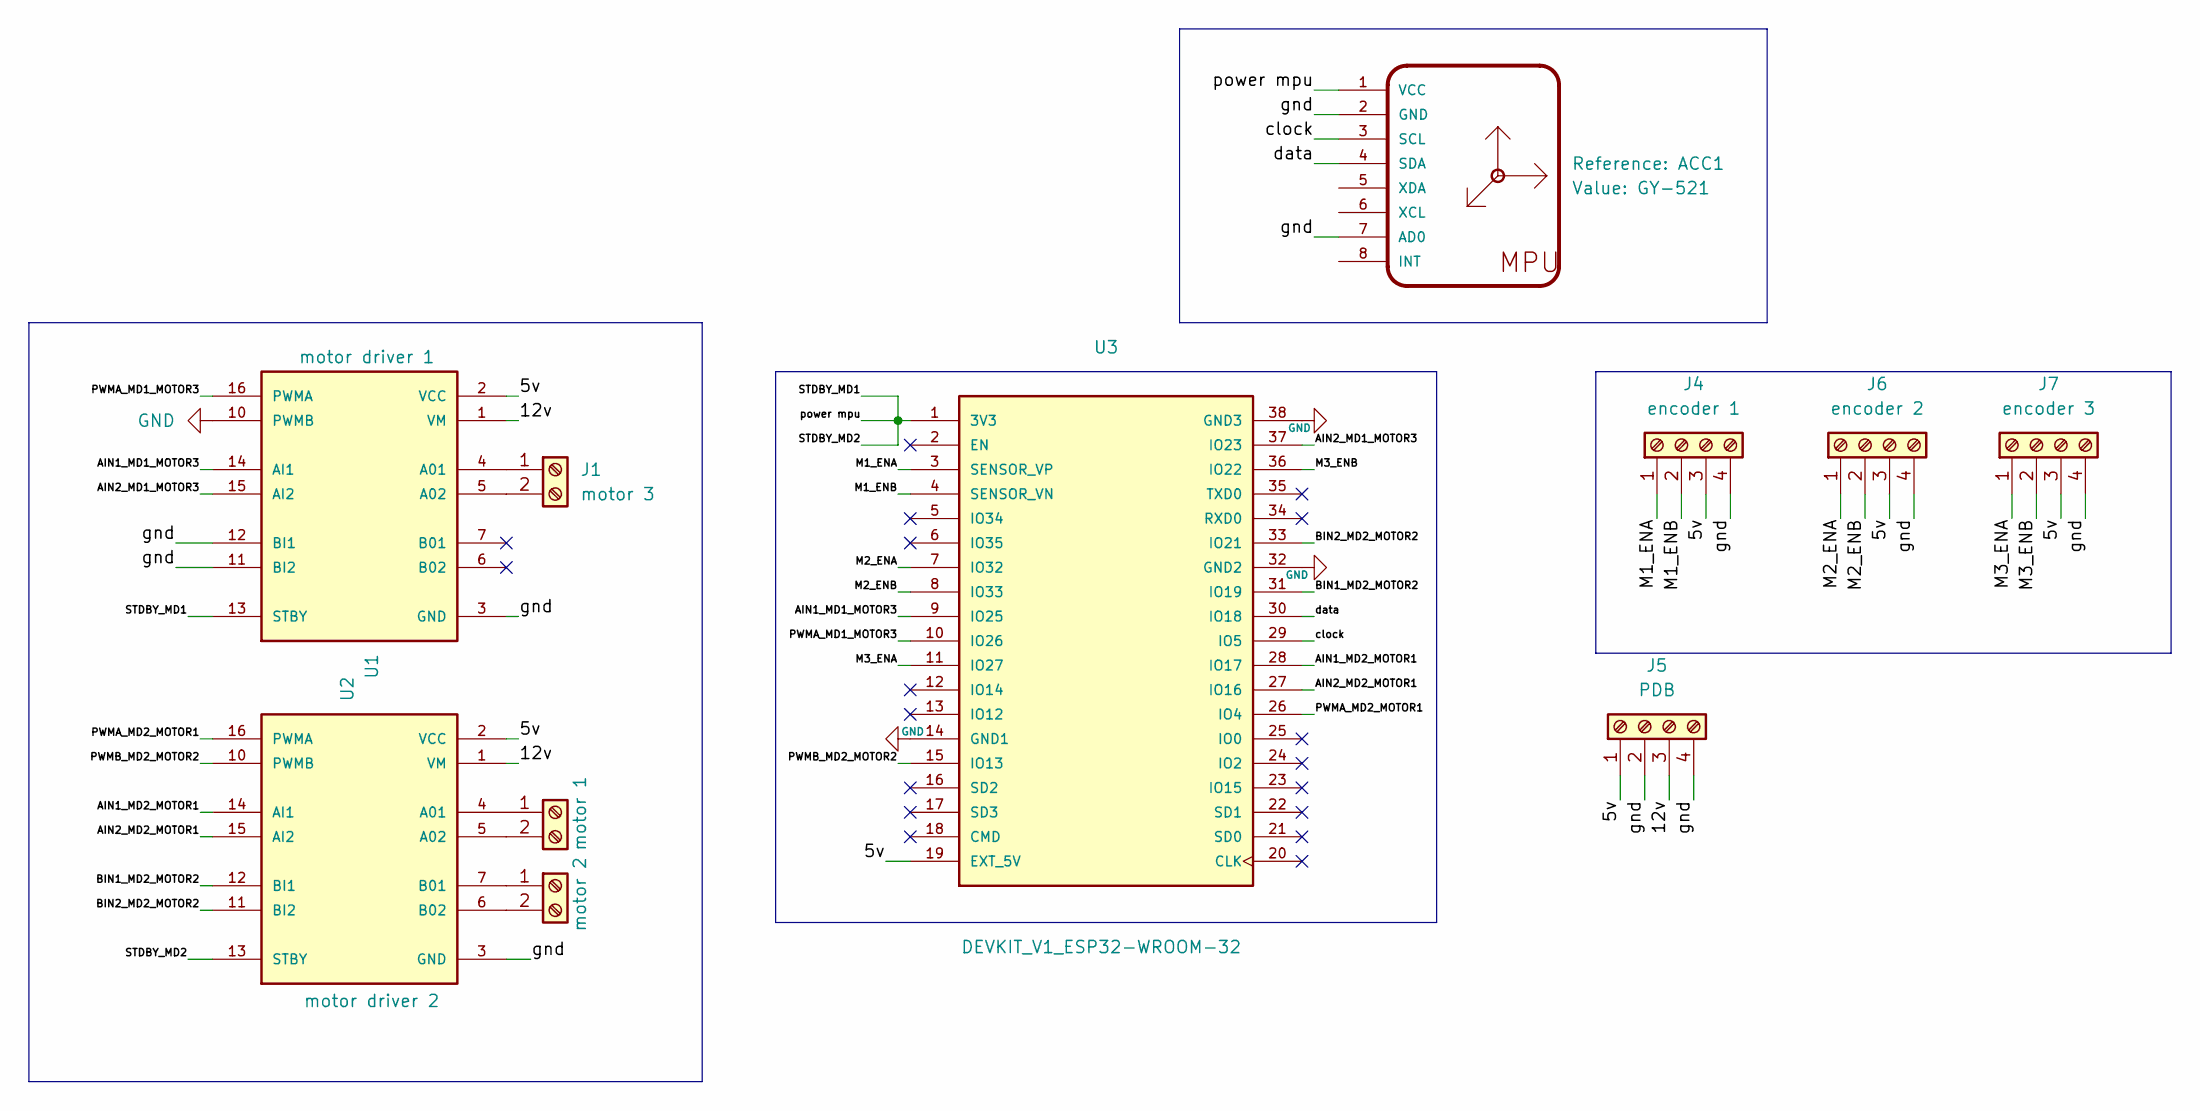
[picture p5: schematic darkviz_draft1schematic.kicad_sch]

Parts:
ACC1: GY-521; PinHeader_1x08_P2.54mm_Vertical
J1: motor 3; TerminalBlock_Phoenix_MKDS-1,5-2-5.08_1x02_P5.08mm_Horizont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
J2: motor 2; TerminalBlock_Phoenix_MKDS-1,5-2-5.08_1x02_P5.08mm_Horizont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
J3: motor 1; TerminalBlock_Phoenix_MKDS-1,5-2-5.08_1x02_P5.08mm_Horizont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
J4: encoder 1; PinHeader_1x04_P2.54mm_Vertical
J5: PDB; PinHeader_1x04_P2.54mm_Vertical
J6: encoder 2; PinHeader_1x04_P2.54mm_Vertical
J7: encoder 3; PinHeader_1x04_P2.54mm_Vertical
U1: motor driver 1; MODULE_ROB-14450; PARTREV 11-13-17
U2: motor driver 2; MODULE_ROB-14450; PARTREV 11-13-17
U3: DEVKIT_V1_ESP32-WROOM-32; MODULE_DEVKIT_V1_ESP32-WROOM-32; PARTREV N/A

Connections:
/5v: J4.3, J5.1, J6.3, J7.3, U1.2 (VCC), U2.2 (VCC), U3.19 (EXT_5V)
/12v: J5.3, U1.1 (VM), U2.1 (VM)
/AIN1_MD1_MOTOR3: U1.14 (AI1), U3.9 (IO25)
/AIN1_MD2_MOTOR1: U2.14 (AI1), U3.28 (IO17)
/AIN2_MD1_MOTOR3: U1.15 (AI2), U3.37 (IO23)
/AIN2_MD2_MOTOR1: U2.15 (AI2), U3.27 (IO16)
/BIN1_MD2_MOTOR2: U2.12 (BI1), U3.31 (IO19)
/BIN2_MD2_MOTOR2: U2.11 (BI2), U3.33 (IO21)
/M1_ENA: J4.1, U3.3 (SENSOR_VP)
/M1_ENB: J4.2, U3.4 (SENSOR_VN)
/M2_ENA: J6.1, U3.7 (IO32)
/M2_ENB: J6.2, U3.8 (IO33)
/M3_ENA: J7.1, U3.11 (IO27)
/M3_ENB: J7.2, U3.36 (IO22)
/PWMA_MD1_MOTOR3: U1.16 (PWMA), U3.10 (IO26)
/PWMA_MD2_MOTOR1: U2.16 (PWMA), U3.26 (IO4)
/PWMB_MD2_MOTOR2: U2.10 (PWMB), U3.15 (IO13)
/STDBY_MD1: ACC1.1 (VCC), U1.13 (STBY), U2.13 (STBY), U3.1 (3V3)
/clock: ACC1.3 (SCL), U3.29 (IO5)
/data: ACC1.4 (SDA), U3.30 (IO18)
GND: ACC1.2 (GND), ACC1.7 (AD0), J4.4, J5.2, J5.4, J6.4, J7.4, U1.3 (GND), U1.8 (GND), U1.9 (GND), U1.10 (PWMB), U1.11 (BI2), U1.12 (BI1), U2.3 (GND), U2.8 (GND), U2.9 (GND), U3.14 (GND1), U3.32 (GND2), U3.38 (GND3)
unnamed: J1.1, U1.4 (A01)
unnamed: J1.2, U1.5 (A02)
unnamed: J2.1, U2.7 (B01)
unnamed: J2.2, U2.6 (B02)
unnamed: J3.1, U2.4 (A01)
unnamed: J3.2, U2.5 (A02)

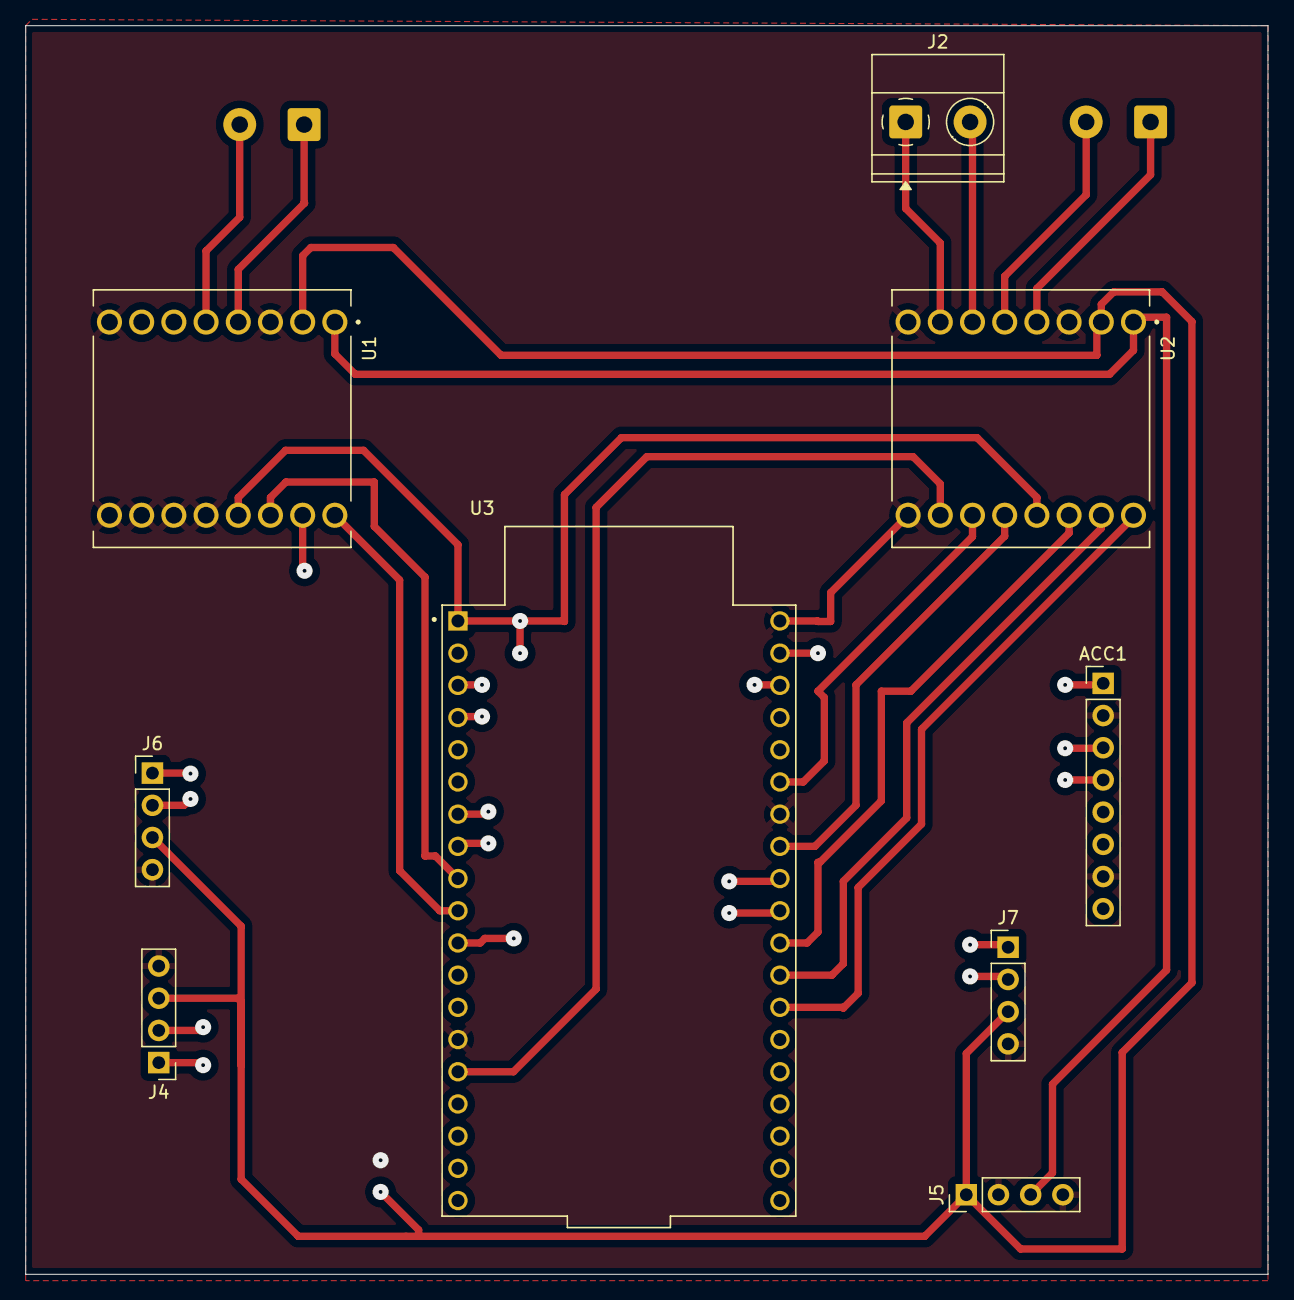
[picture p6: board initial_pcb_draft.kicad_pcb from above]

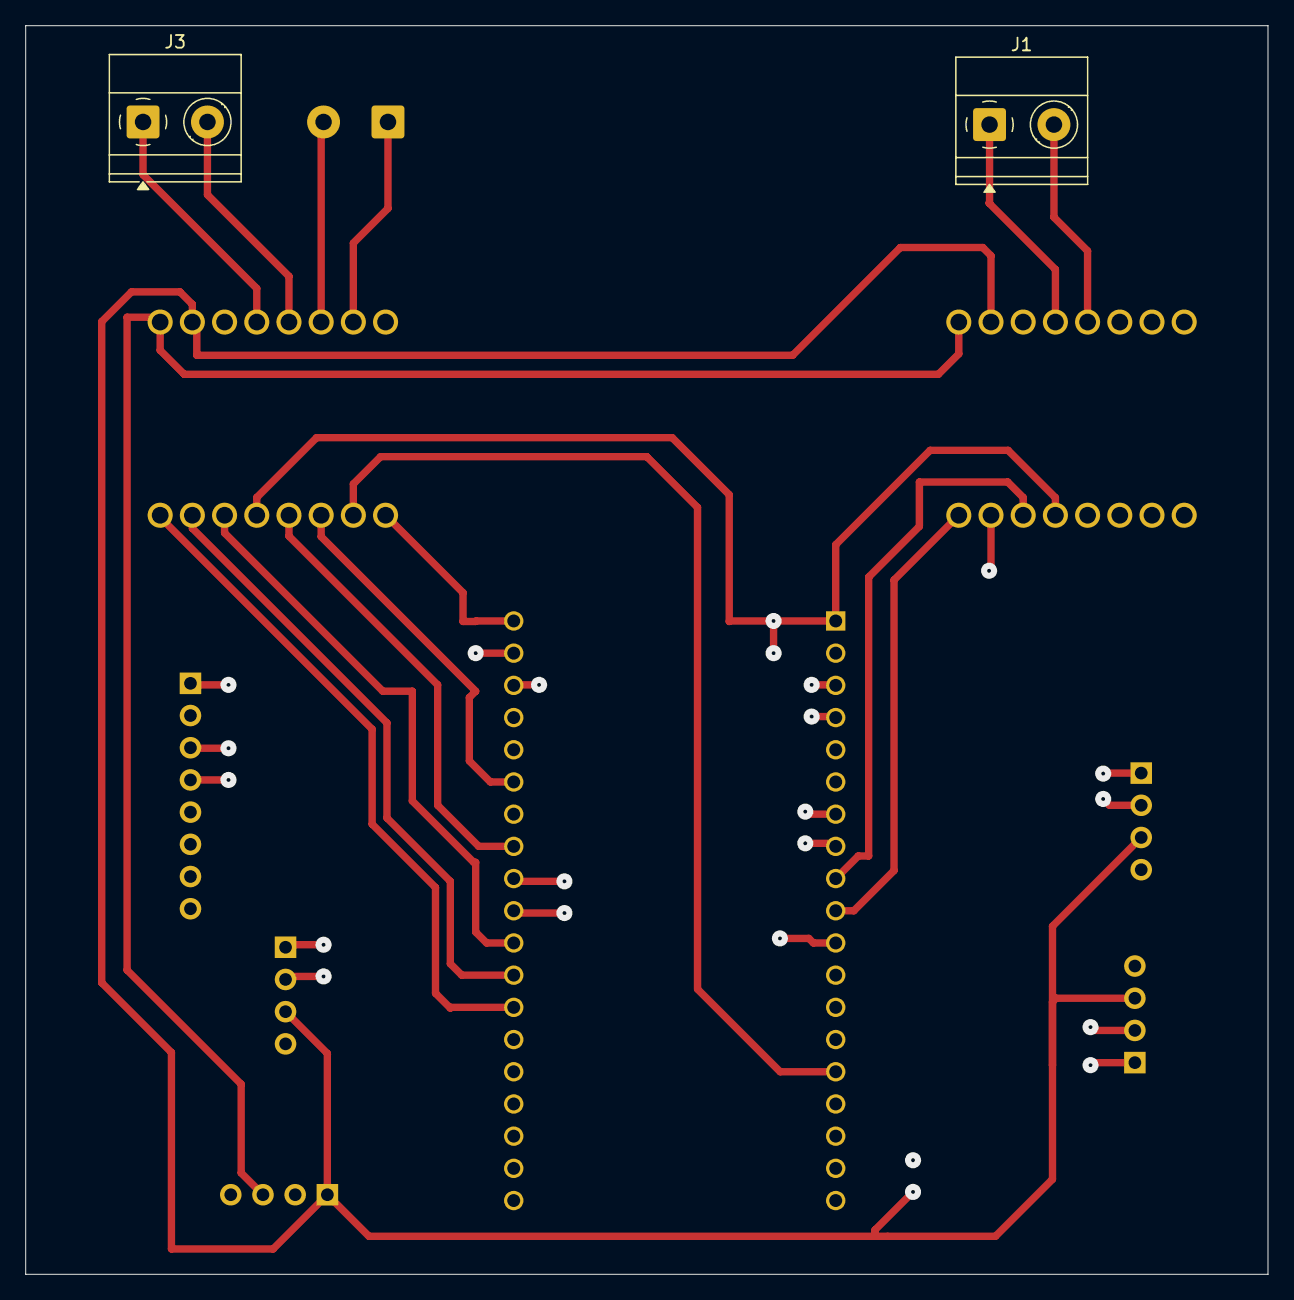
[picture p7: board initial_pcb_draft.kicad_pcb from below]

Board: 2 copper layers, 98.0 x 98.5 mm, 11 parts (2 on the bottom side), 27 nets.
