Shreeyaj005/Darkviz/(commit log)

2026-08-11 Update project timeline with current status
2026-08-12 Create CAD
2026-08-13 warehouse world working
    [kiwi_world.sdf]
2026-08-13 revised world and integrated omniwheel robot
    [kiwi_robot.urdf.xacro]
2026-08-21 conveyor belt added
    [kiwi_world.sdf]
2026-09-22 Teleoperation script added
    [kiwi_robot.urdf.xacro]
2026-09-22 CAD FILE /3D PRINT
    PROJECT DESCRIPTION:
    This CAD assembly features a custom 3D-printable horizontal extendable tray mechanism driven by a rack-and-pinion system for a 20 cm stroke travel. It integrates an optimized 1.25 Module pitch rack merged into a female sliding carriage, driven by a 24-tooth spur gear with a 30 mm pitch diameter. The mechanism is fully constrained using a Slider Joint and Motion Link, providing 94.25 mm linear travel per gear revolution to simulate realistic dynamic motion. Powered by a standard NEMA 17 stepper motor mounted on a fixed male base rail interface, it eliminates the need for commercial rails by using an additive-manufacturing-friendly design.
    KEY COMP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
    [final design.step]
2026-09-22 Enhance README with flowchart and implementation details
    Updated the README to include a flowchart image and detailed algorithm steps for the DarkViz project. Added implementation details for hardware and software, along with result images and video links.
2026-09-22 revised changes
    [kiwi_robot.urdf.xacro, kiwi_world.sdf]
2026-09-22 Add files via upload
    Updated kiwi-drive CAD with reinforced structure and compact holder
    [darkviz_base.stl]
2026-09-22 Added 3D-printed prototype and hardware assembly images
    Added photographs of the 3D-printed robot prototype, showing the updated compact mechanical design, reinforced structure, motor mounting system, omni-wheel configuration, and integration of the ESP32, motor drivers, and encoder wiring.
2026-09-22 Create Robot Control
    Added initial ESP32 robot control program
2026-09-23 Changed structure
    [final design.step, kiwi_robot.urdf.xacro, kiwi_world.sdf]
2026-10-23 Add wiring connections for DarkViz Robot motors
2026-10-24 Add wiring details for DarkViz Robot motors and encoders
2026-10-24 initial Kiwidrive circuit schematic draft
2026-10-24 initial kiwi drive pcb draft
2026-10-24 Added 3D-printed chassis base model
    Added the 3D model of the Kiwi-drive robot chassis base, prepared for 3D printing using Bambu Studio. The base provides the main structural platform for mounting the three motor assemblies and supporting the robot's mechanical and electronic components.
